Adimazuz/AutoRaceCar/docs/misc/opticl flow.png

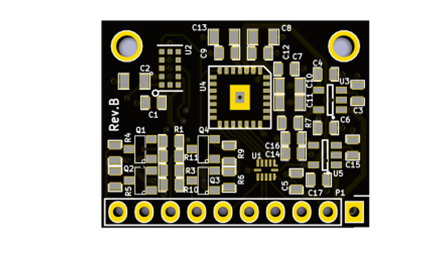
docs/misc/opticl flow.png
