Adimazuz/AutoRaceCar/docs/car_pics/WhatsApp Image 2019-09-23 at 13.06.30 (4).jpeg

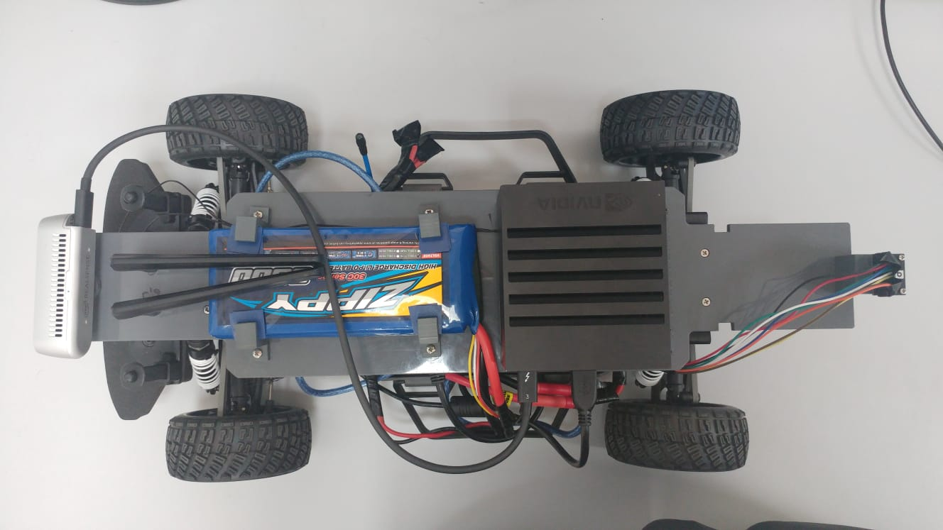
docs/car_pics/WhatsApp Image 2019-09-23 at 13.06.30 (4).jpeg
