Adimazuz/AutoRaceCar/docs/class - Arduino.rtf

Arduino

úéàåø äîçì÷ä:
Arduino äéà îçì÷ä äéåøùú îäîçì÷ä äàáñèø÷èéú MotorAPI – îçì÷ä äîâãéøä àú ôåð÷öéåú äîîù÷ äãøåùåú (ìî÷øä ùì ùéðåé òúéãé îàøãåàéðå)
äîçì÷ä îëéìä áúåëä ôåð÷öéåú îîù÷ òáåø ëì äøëéáéí äîçåáøéí ìàøãåàéðå , äîðåò , ääéâåé åäoptic sensor

ôøîèøéí òáåø äîçì÷ä:
speed : îäéøåú ðéðúðú áîñôø ùìí çñø éçéãåú äðò áéï [-30,30] (îñôø æä îééöâ àú äòøê äðùìç àì äPWM ùì äàøãåàéðå)
Angle : äæååéú ðùìçú áîòìåú , äòøëéí äàôùøééí [60,130]

ôåð÷öéåú äîîù÷:

bool Arduino::connect()

úéàåø äôåð÷öéä:
äôåð÷öéä îúçáøú ìú÷ùåøú ñéøàìéú àì îåì äàøãåàéðå ìîîù÷.

ôøîèøéí:
àéï.

òøê äçæøä:
îöáéò ìîîù÷.

Arduino &Arduino::drive(const int &wanted_speed, const int &wanted_angle)
úéàåø äôåð÷öéä:
äôåð÷öéä ùåìçú ô÷åãú ðñéòä ìîðåò åäâìâìéí åâåøîú ìå ìðñåò áîäéøåú åäæååéú äðúåðåú òã ìô÷åãä çãùä

ôøîèøéí:
wanted_speed – äîäéøåú äøöåéä
wanted_angle – äæååéú äøöåéä

òøê äçæøä:
îçæéø àú äîîù÷ çæøä ìöåøê ùøùåø ôåð÷öéåú.

Arduino &Arduino::changeSpeed(const int &wanted_speed)
úéàåø äôåð÷öéä:
äôåð÷öéä ùåìçú ô÷åãú ðñéòä ìîðåò åâåøîú ìå ìðñåò áîäéøåú äðúåðä òã ìô÷åãä çãùä

ôøîèøéí:
wanted_speed – äîäéøåú äøöåéä

òøê äçæøä:
îçæéø àú äîîù÷ çæøä ìöåøê ùøùåø ôåð÷öéåú.

Arduino& Arduino::changeSpeedBy(const int &delta)
úéàåø äôåð÷öéä:
äôåð÷öéä ùåìçú ô÷åãä ìîðåò ìùðåú àú äîäéøåú áîñôø äðúðåú

ôøîèøéí:
delta – áëîä éçéãåú ìùðåú àú äîðåò îäîöá äðåëçé

òøê äçæøä:
îçæéø àú äîîù÷ çæøä ìöåøê ùøùåø ôåð÷öéåú.

Arduino &Arduino::changeAngle(const int &wanted_angle)
úéàåø äôåð÷öéä:
äôåð÷öéä ùåìçú ô÷åãä ìäéâåé åâåøîú ìå ìùðåú àú äâìâìéí áæååéú äðúåðä òã ìô÷åãä çãùä

ôøîèøéí:
wanted_angle – äæååéú äøöåéä

òøê äçæøä:
îçæéø àú äîîù÷ çæøä ìöåøê ùøùåø ôåð÷öéåú.

Arduino& Arduino::changeAngleBy(const int &delta)
úéàåø äôåð÷öéä:
äôåð÷öéä ùåìçú ô÷åãä ìäéâåé åâåøîú ìå ìäåñéó àå ìäçñéø îòìåú îæååéú äâìâìéí

ôøîèøéí:
delta – áëîä îòìåú ìùðåú àú äæååéú îäîöá äðúåï

òøê äçæøä:
îçæéø àú äîîù÷ çæøä ìöåøê ùøùåø ôåð÷öéåú.

Arduino &Arduino::stop()

úéàåø äôåð÷öéä:
äôåð÷öéä ùåìçú ô÷åãú òöéøä, òåöøú àú äîðåò åîééùøú àú äâìâìéí

ôøîèøéí:
àéï

òøê äçæøä:
îçæéø àú äîîù÷ çæøä ìöåøê ùøùåø ôåð÷öéåú.

Arduino &Arduino::driveCurrentState(){

úéàåø äôåð÷öéä:
äôåð÷öéä ùåìçú ô÷åãä ìäîùéê ìðñåò áîöá äðåëçé

ôøîèøéí:
àéï

òøê äçæøä:
îçæéø àú äîîù÷ çæøä ìöåøê ùøùåø ôåð÷öéåú.
