Adimazuz/AutoRaceCar/docs/misc/bitcraze_image.jpg

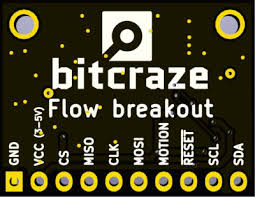
docs/misc/bitcraze_image.jpg
