Adimazuz/AutoRaceCar/lower platform/65e01139-e94f-471c-8ce6-9d048b3abe47.jpg

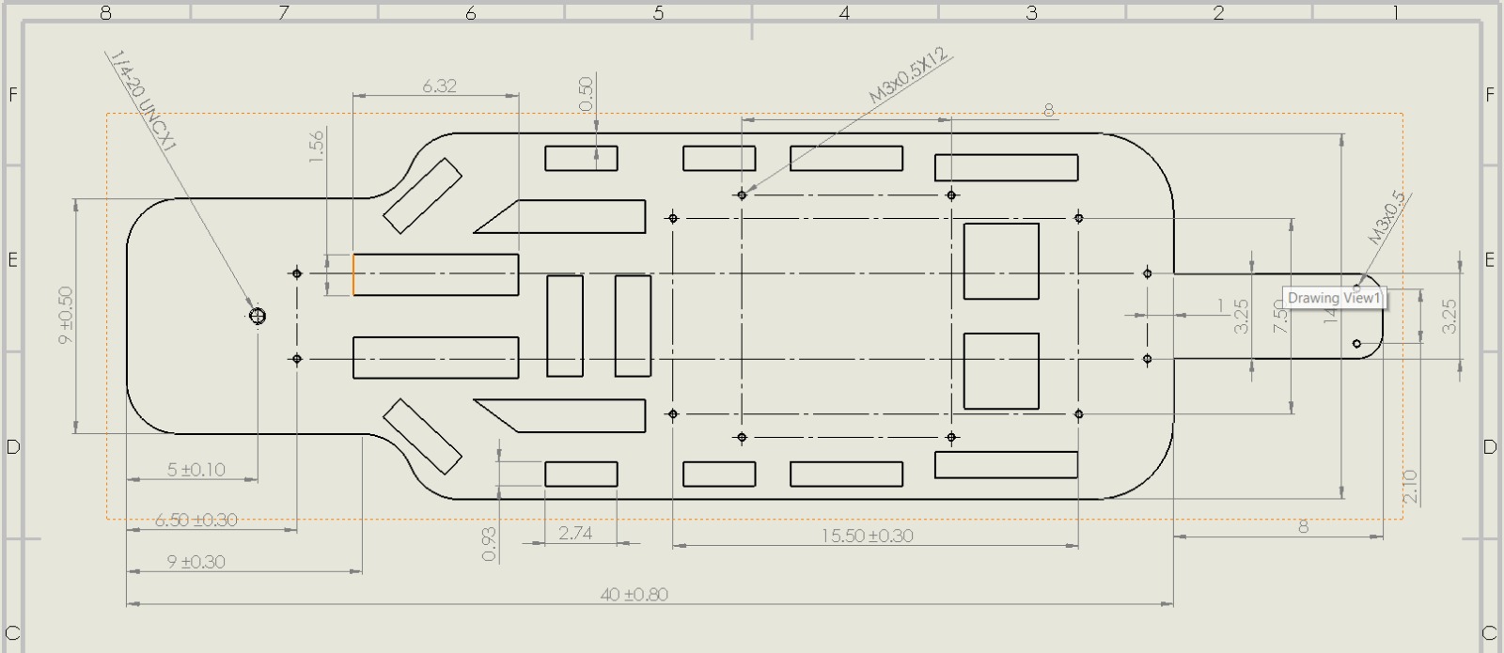
lower platform/65e01139-e94f-471c-8ce6-9d048b3abe47.jpg
