Adimazuz/AutoRaceCar/lower platform/Racecar platform part.STEP

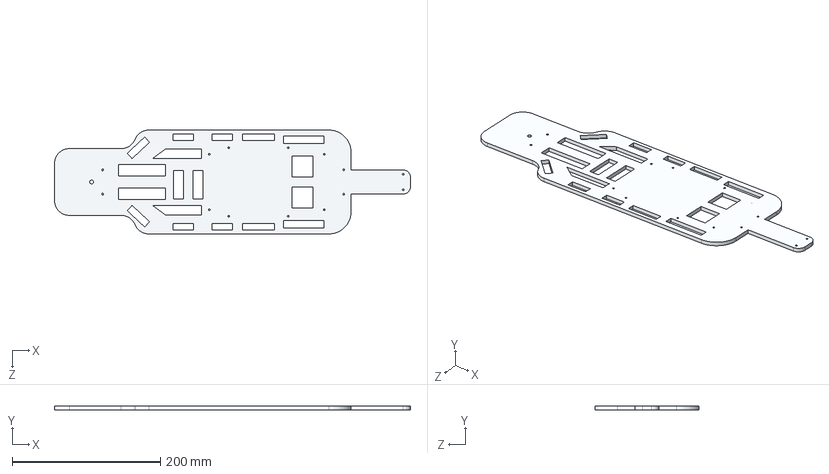
[picture p33: CAD file, 2019-05-25]
lower platform/Racecar platform part.STEP
480.0 x 5.00 x 140.0 mm
