Adimazuz/AutoRaceCar/(list of files, cad)

Other CAD files:
lower platform/raceCarPlatform.SLDPRT
lower platform/raceCarPlatform.SLDDRW
