Adimazuz/AutoRaceCar/docs/install turbo-jpeg.odt

1. Download nasm http://www.nasm.us/pub/nasm/releasebuilds/2.14.02/nasm-2.14.02.tar.xz

2. extract the downloaded file

3. open terminal in folder

4. run

“./configure --prefix=/usr && make”

5. run

“sudo make install”

and add password

6. download libjpeg-turbo https://downloads.sourceforge.net/libjpeg-turbo/libjpeg-turbo-2.0.2.tar.gz

7. extract the downloaded file

8. run

“mkdir build &&

cd build &&

cmake -DCMAKE_INSTALL_PREFIX=/usr \

-DCMAKE_BUILD_TYPE=RELEASE \

-DENABLE_STATIC=FALSE \

-DCMAKE_INSTALL_DOCDIR=/usr/share/doc/libjpeg-turbo-2.0.2 \

-DCMAKE_INSTALL_DEFAULT_LIBDIR=lib \

.. &&

make”

9. run

“sudo make install”

and add password

10. if an error appears while running the gui about openGl library(if noone installed before the openGl lib) so run

“sudo apt-get install libglu1-mesa-dev freeglut3-dev mesa-common-dev

“
