Adimazuz/AutoRaceCar/docs/Ford-Fiesta-ST-Rally/74054-4_Rally_TQi_explodedviews_181218_74054-4-Driveshafts-Assembly.jpg

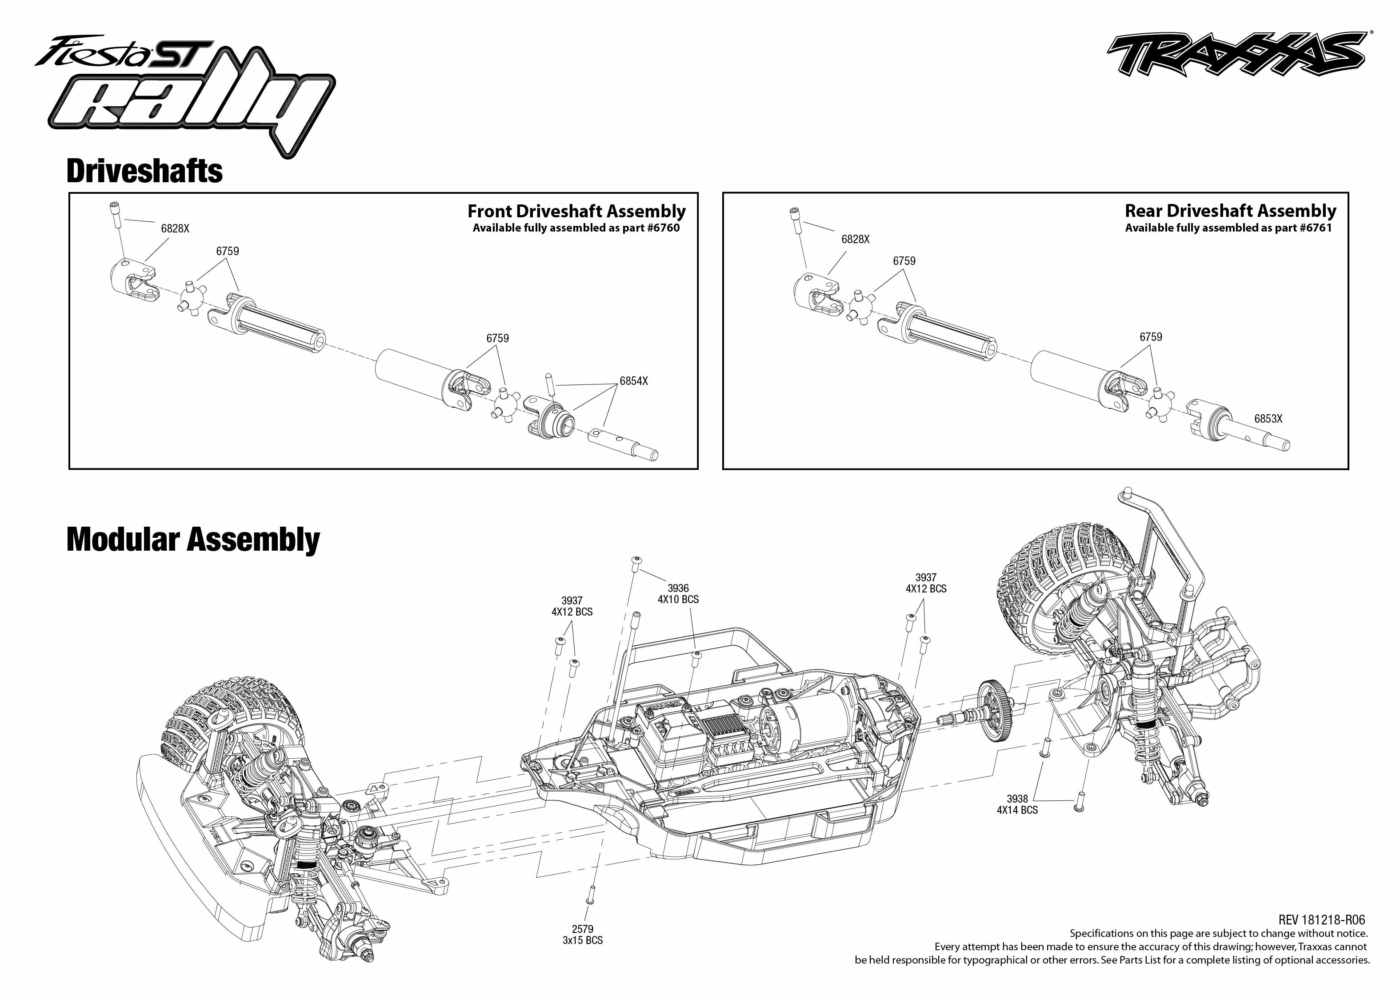
docs/Ford-Fiesta-ST-Rally/74054-4_Rally_TQi_explodedviews_181218_74054-4-Driveshafts-Assembly.jpg
