Adimazuz/AutoRaceCar/lower platform/Racecar Platform Drawing.PDF

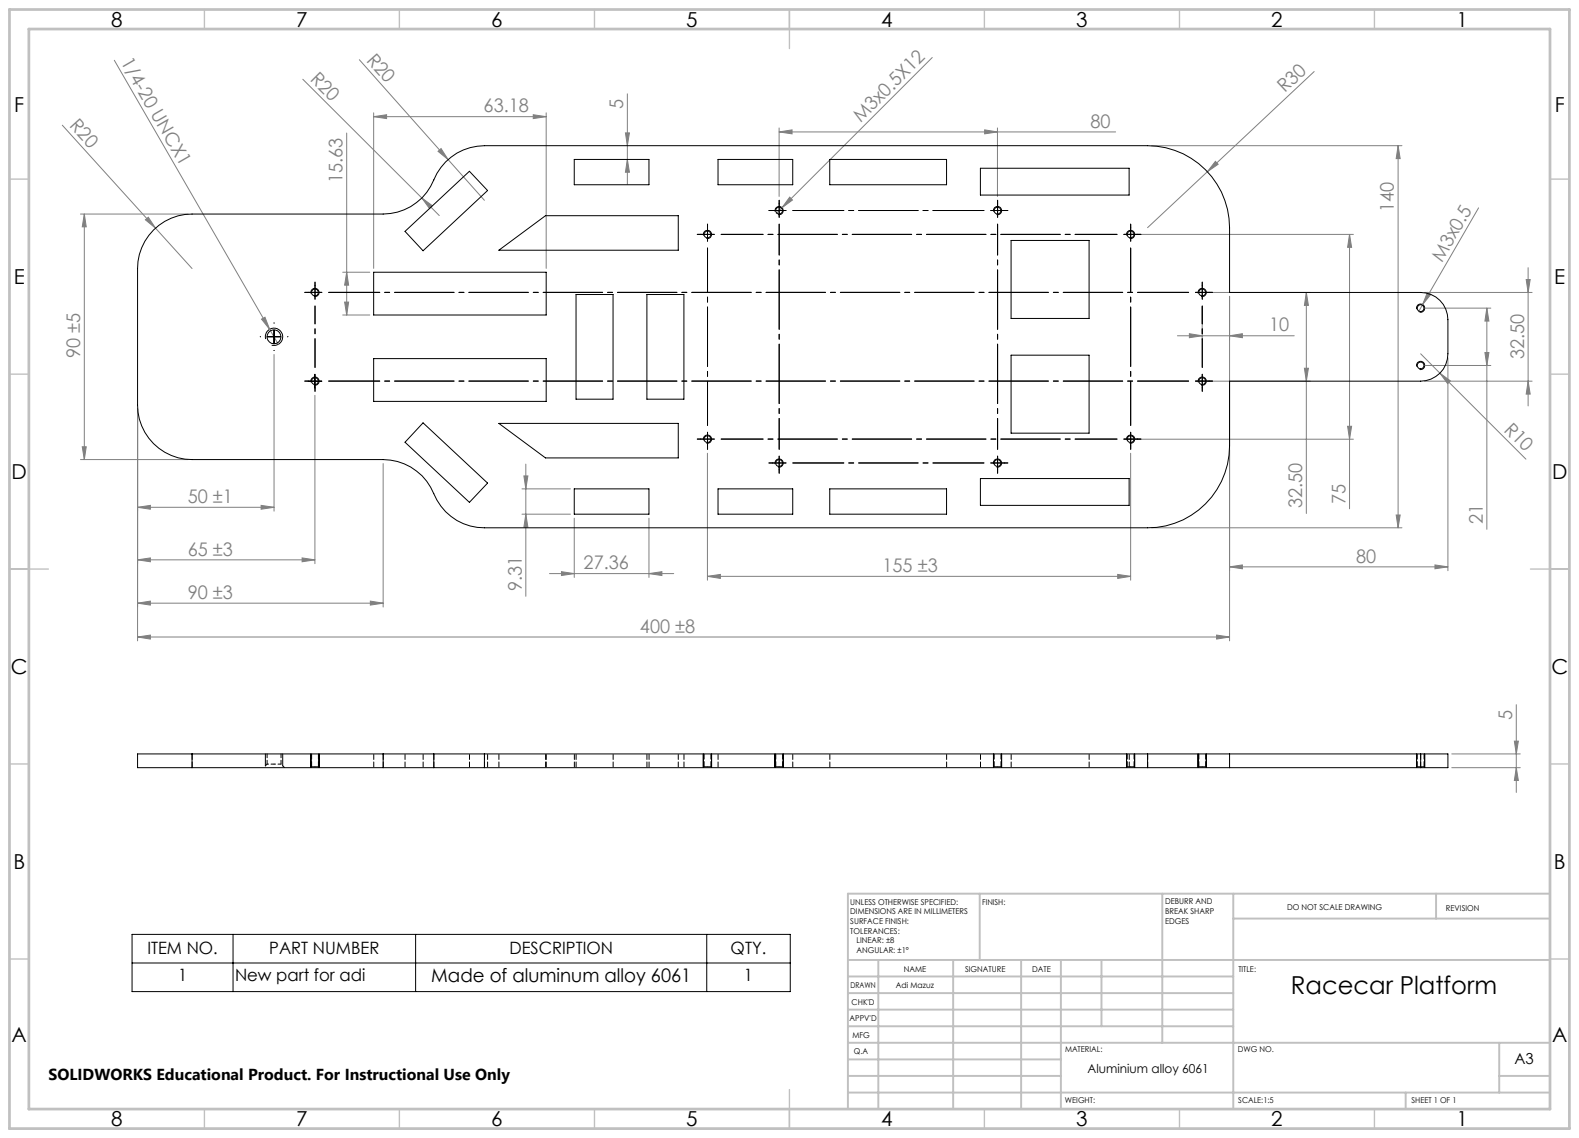
[picture p39: page 1]
1/4-20 UNCX1; New part for adi; Made of aluminum alloy 6061; FINISH:; DEBURR AND; BREAK SHARP; DO NOT SCALE DRAWING; REVISION; SCALE:1:5; SHEET 1 OF 1; Adi Mazuz; Racecar Platform

UNLESS OTHERWISE SPECIFIED:
DIMENSIONS ARE IN MILLIMETERS
SURFACE FINISH:
TOLERANCES:
LINEAR: ±8
ANGULAR: ±1°

ITEM NO. | PART NUMBER | DESCRIPTION | QTY.

APPV'D
MFG
Q.A | MATERIAL: | DWG NO. | A3 Aluminium alloy 6061

SOLIDWORKS Educational Product. For Instructional Use Only
