Adimazuz/AutoRaceCar/(list of files, drawings)

Other design files:
docs/misc/arduino_nano_connections.fzz
