Adimazuz/AutoRaceCar/TcpClient/TcpClient.cpp

#include <iostream>

#include "Exceptions.h"
#include "TcpClient.h"

#ifdef _WIN32
#include <inaddr.h>
#else
    #include <arpa/inet.h>
    #include <unistd.h> 
    #include <fcntl.h>
#endif

TcpClient::TcpClient() noexcept :
        _socket(-1),
        _address(),
        _is_connected(false)
{
#ifdef _WIN32
    WSADATA wsa;
    WSAStartup(MAKEWORD(2, 0), &wsa);
#endif
}

void TcpClient::connect(const string& ip, const unsigned short& port)
{
    if(isConnected())
    {
        return;
    }

    createSocket();

    sockaddr_in server_address = buildAddress(ip, port);

    int res = ::connect(_socket, reinterpret_cast<sockaddr*>(& server_address),
                        sizeof(server_address));
    if(res < 0)
    {
        _is_connected = false;
        return;
    }

    _is_connected = true;
}

TcpClient &TcpClient::createSocket()
{
    _socket = socket(AF_INET, SOCK_STREAM, 0);

    if(_socket == -1)
    {
        throw ITcpClientCannotCreateSocket();
    }

    return *this;
}

void TcpClient::receive(char *dst, const uint &len, const uint &timeout_sec)
{
    if(timeout_sec > 0)
    {
        setTimeout(timeout_sec);
    }

    uint bytes_received = 0;

    while(bytes_received < len)
    {
        long tmp_len = 0;

        if(timeout_sec == 0)
        {
            tmp_len = recv(_socket, dst + bytes_received, len - bytes_received, MSG_DONTWAIT);
        }
        else
        {
            tmp_len = recv(_socket, dst + bytes_received, len - bytes_received, 0);
        }

        if(tmp_len == 0)
        {
            disconnect();
            return;
        }

        else if(tmp_len < 0)
        {
            return;
        }

        bytes_received += tmp_len;
    }
}

void TcpClient::send(const std::vector<char> &data) noexcept
{
    uint bytes_sent = 0;
    while (bytes_sent < data.size())
    {
        auto tmp_len = ::send(_socket, data.data() + bytes_sent, data.size() - bytes_sent, MSG_NOSIGNAL);

        if(tmp_len < 0)
        {
            disconnect();
            return;
        }

        bytes_sent += tmp_len;
    }
}

void TcpClient::send(const string &message) noexcept
{
    uint bytes_sent = 0;
    uint len = static_cast<uint>(message.size());
    while (bytes_sent < message.size())
    {
        auto tmp_len = ::send(_socket, message.c_str() + bytes_sent, len - bytes_sent, MSG_NOSIGNAL);

        if(tmp_len < 0)
        {
            disconnect();
            return;
        }

        bytes_sent += tmp_len;
    }
}

void TcpClient::send(const char *data, const uint &len) noexcept
{
    uint bytes_sent = 0;
    while (bytes_sent < len)
    {
        auto tmp_len = ::send(_socket, data + bytes_sent, len - bytes_sent, MSG_NOSIGNAL);

        if(tmp_len < 0)
        {
            disconnect();
            return;
        }

        bytes_sent += tmp_len;
    }
}

void TcpClient::disconnect()
{
#ifdef _WIN32
    closesocket(_socket);
#else
    close(_socket);
    _is_connected = false;
#endif
}

sockaddr_in TcpClient::buildAddress(const string &ip, const unsigned short &port) const noexcept
{
    sockaddr_in address;

#ifdef _WIN32
    address.sin_addr.S_un.S_addr = inet_addr(ip.c_str());
#else
    address.sin_addr.s_addr = inet_addr(ip.c_str());
#endif

    address.sin_family = AF_INET;
    address.sin_port = htons(port);

    return address;

}

TcpClient &TcpClient::setTimeout(const uint &timeout_sec)
{
    struct timeval tv;
    tv.tv_sec = timeout_sec;
    tv.tv_usec = 0;
    setsockopt(_socket, SOL_SOCKET, SO_RCVTIMEO, reinterpret_cast<const char*>(&tv), sizeof tv);

    return *this;
}

TcpClient::~TcpClient()
{
    disconnect();
}
