Adimazuz/AutoRaceCar/UdpClient/UdpClient.cpp

#include "UdpClient.h"
#include "Exceptions.h"
#include <iostream>
<<<<<<< HEAD
#include <thread>
=======
>>>>>>> 80c1c94995ff7f9ba110acdd6402e529cede8335

UdpClient::UdpClient(const string &ip, const ushort &port) :
    _socket(-1),
    _server_addres()
{
    _server_addres.sin_family = AF_INET;
    _server_addres.sin_port = htons(port);
    _server_addres.sin_addr.s_addr = inet_addr(ip.c_str());

    createSocket();
}

std::vector<char> UdpClient::receive(const unsigned long &len) noexcept
{
    std::vector<char> buffer(len);

    socklen_t address_size = static_cast<unsigned int>(sizeof(_server_addres));

    recvfrom(_socket, buffer.data(), len, 0, reinterpret_cast<sockaddr*>(&_server_addres), &address_size);

    return buffer;
}

void UdpClient::send(const std::vector<char> &msg)
{
    sendto(_socket, msg.data(), msg.size(), 0, reinterpret_cast<sockaddr*>(&_server_addres), sizeof(_server_addres));
}

void UdpClient::send(const string &msg)
{
    sendto(_socket, msg.data(), msg.size(), 0, reinterpret_cast<sockaddr*>(&_server_addres), sizeof(_server_addres));
}

void UdpClient::send(const char *data, const uint &len)
{
    uint tot_bytes_sent = 0;
    while(tot_bytes_sent < len)
    {
        uint to_sent = len - tot_bytes_sent;
        if(to_sent > 65507)
        {
            to_sent = 65507;
        }
        auto s = sendto(_socket, data, to_sent, 0, reinterpret_cast<sockaddr*>(&_server_addres), sizeof(_server_addres));
<<<<<<< HEAD
        std::this_thread::sleep_for(std::chrono::milliseconds(200));
=======
>>>>>>> 80c1c94995ff7f9ba110acdd6402e529cede8335
        std::cout << s << std::endl;
        tot_bytes_sent += s;
    }
}

UdpClient &UdpClient::createSocket()
{
    _socket = socket(AF_INET, SOCK_DGRAM, 0);

    if(_socket < 0)
    {
        throw UDPClientCannotCreateSocket();
    }

    return *this;
}
