Adimazuz/AutoRaceCar/arduino/bitcraze/bitcraze_types.h

#ifndef FLOW_HPP
#define FLOW_HPP

enum Commands : char
{
  START_STREAMING = '#',
  STOP_STREAMING = '!'
};

#pragma pack(push,1)
struct Flow
{
  short deltaX;
  short deltaY;
  float range;
  short dt;
};

#pragma pack(pop)

#endif
