Adimazuz/AutoRaceCar/UdpClient/UdpClient_types.h

#ifndef UDPCLIENT_TYPES_H
#define UDPCLIENT_TYPES_H

#include <string>
#include <sys/types.h>
#include <sys/socket.h>
#include <arpa/inet.h>
#include <netinet/in.h>
#include <vector>
#include <memory>

using string = std::string;
using Socket = int;

#endif // UDPCLIENT_TYPES_H
