Adimazuz/AutoRaceCar/(commit log)

2019-04-30 socket client and server
2019-05-21 added arduino
2019-05-21 lower platform + servo returning slowly
    [raceCarPlatform.SLDDRW, raceCarPlatform.SLDPRT]
2019-05-25 added platform files
    [Racecar platform part.STEP]
2019-05-28 adding class for controling arduino
2019-06-03 deleted main.cpp from MotorAPI Cmake
2019-06-04 start cameraAPI
2019-06-05 cameraAPI updates
2019-06-11 fixed Cmake files added libs
    [Arduino.cpp, Arduino.h, ITcpClient.h, MotorController.h, RaceCar.cpp, RaceCar.h]
2019-06-11 color frames support
2019-06-11 camera: added exceptions
2019-06-11 camera excep update
2019-06-11 camera working
2019-06-18 Arduino TCP control working
2019-07-27 added bitcraze to arduino
2019-07-27 added send Flow to TCP server
2019-07-27 changed PWMS
2019-07-27 update tcp sockets interfaces
2019-07-29 cameraAPI adapted to CameraTypes
2019-07-29 cameraAPI fixes of ints/uints
    [Camera_types.h]
2019-07-29 camera distructor+status added
2019-08-03 fix UdpServer & UdpClient
    [UdpClient.cpp]
2019-08-03 intrinsics added from depth camera
2019-08-03 getExtrinsics added to camera
2019-08-05 fix TcpAlient remove const
    [ITcpClient.h, TcpClient.cpp, TcpClient.h]
2019-08-05 small changes to arduino
2019-08-10 camera: added euler angles
2019-08-10 added sending Flow
2019-08-13 fix unblocking features tcp client\server
    [ITcpClient.h, ITcpServer.h, TcpClient.cpp, TcpClient.h, TcpServer.cpp, TcpServer.h, main.cpp]
2019-08-14 bug on control commands to arduino
    [Arduino.cpp, Arduino_types.h, RaceCar.cpp, RaceCar.h, TcpServer.cpp]
2019-08-14 flow in run ouside the inter scope
2019-08-14 seprated arduino to 2 files
2019-08-16 WORKED_STABLE VERSION with 2 arduinos
2019-08-17 arduino types => bitcraze types
2019-08-17 write enums to arduino
2019-08-17 fixed app/tcp bugs on remote
    [Arduino_types.h, TcpClient.cpp]
2019-08-24 added camera TS & bytes_per_pixel
2019-08-31 added arduino uno image
2019-08-31 working on infrared frames
2019-08-31 added fritzing to arduino nano
2019-08-31 added new function to motor control docs
2019-08-31 changed doc names
    [arduino_nano_connections.fzz]
2019-08-31 added depth frames send with Zlib
2019-09-03 added new ressolution to IR camera ui
2019-09-03 added functions to choose frame
2019-09-06 frame stream switch on remote added
2019-09-06 add camera requests on the fly
2019-09-06 fix bitcraze! now works even after the system crushed
    [RaceCar.cpp, bitcraze.ino, bitcrazeArd.cpp, bitcrazeArd.h]
2019-09-06 calculate optical flow speed
2019-09-07 added to final doc, need to change some more tommorow
    [arduino_nano_connections.fzz]
2019-09-10 camera docs added
2019-09-12 changed ressolution of servo
2019-09-12 fix servo ress
2019-09-12 convert velocity equations o radians
2019-09-12 added cables pics
2019-09-17 fixed speed resulition in docs
    [Arduino.h]
2019-09-23 test cable
2019-09-23 cable failed test
